georf/StopWatchDisplay/7segment/7segment.kicad_pcb

## KiCad design 7segment/7segment.kicad_pcb (2021-03-15)

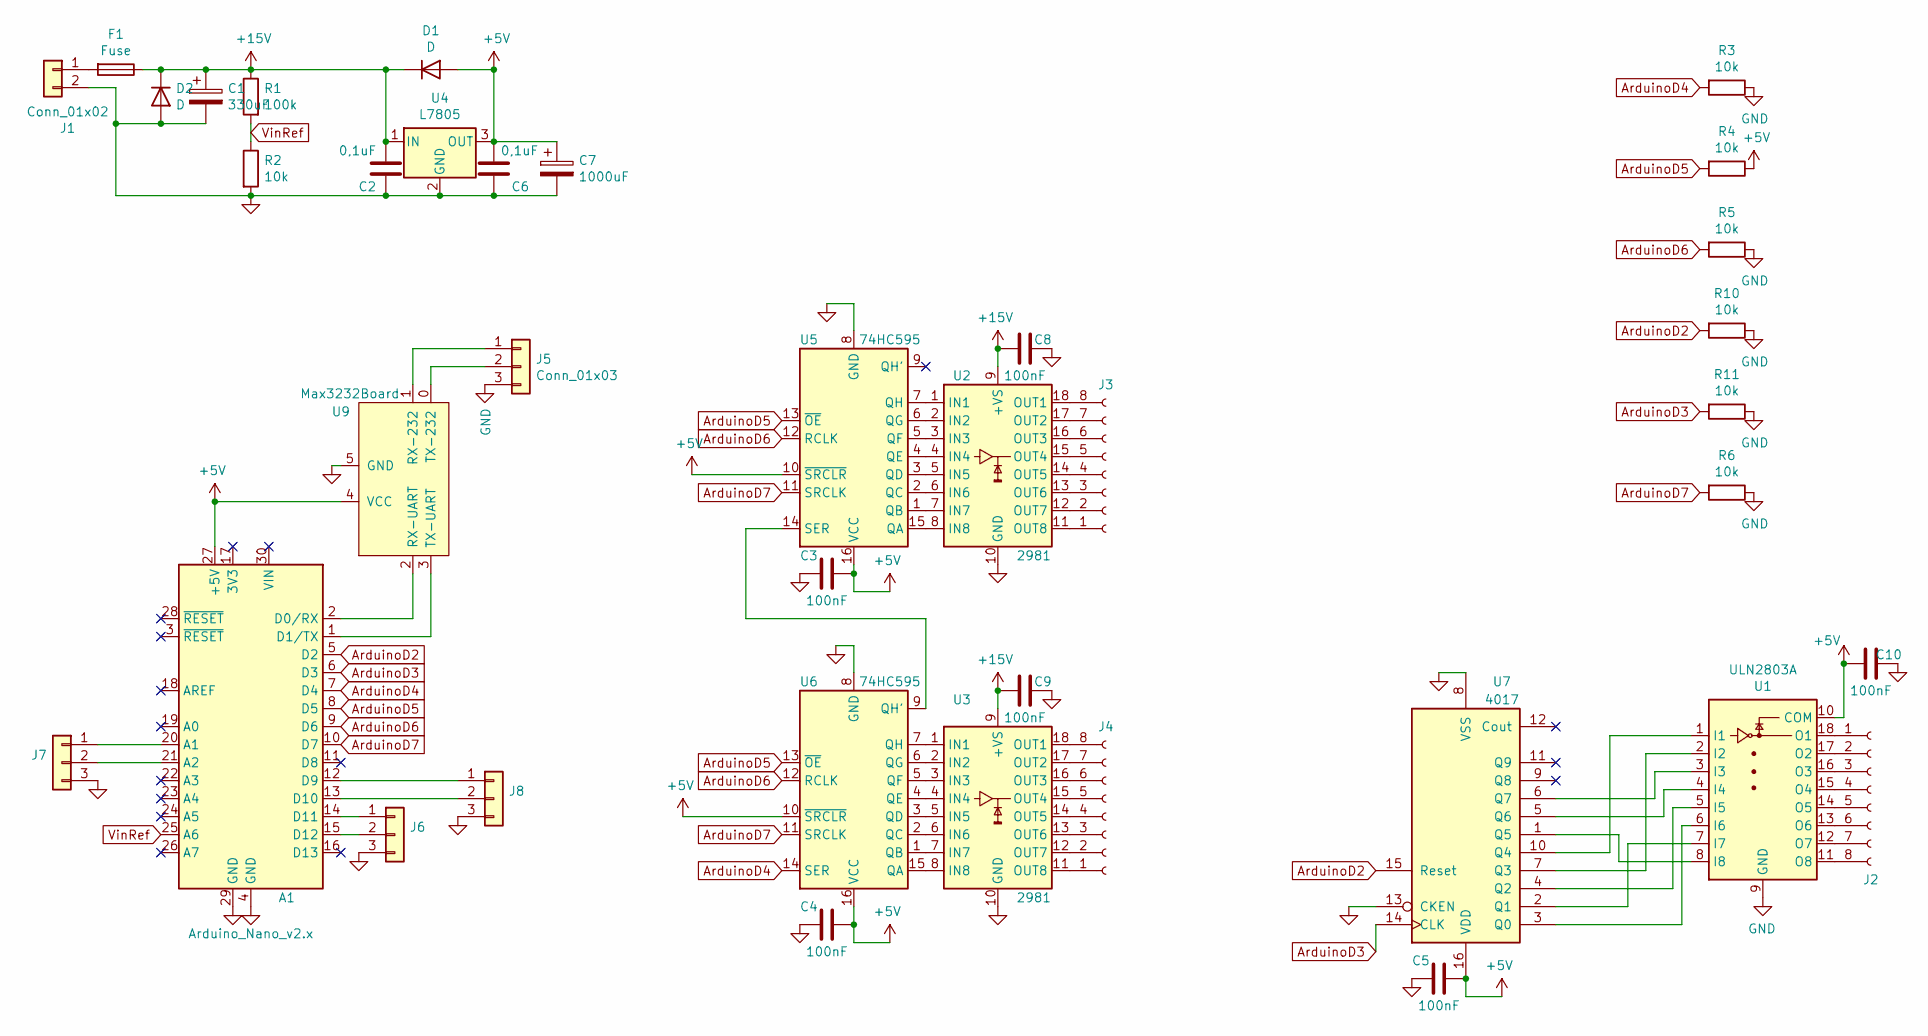
[picture p1: schematic 7segment.sch]

Parts:
A1: Arduino_Nano_v2.x; Arduino_Nano
C1: 330uF; CP_Radial_D10.0mm_P5.00mm
C2, C6: 0,1uF; C_Disc_D3.4mm_W2.1mm_P2.50mm
C3, C4, C5, C8, C9, C10: 100nF; C_Disc_D5.0mm_W2.5mm_P2.50mm
C7: 1000uF; CP_Radial_D10.0mm_P5.00mm
D1: D; D_A-405_P10.16mm_Horizontal
D2: D; D_A-405_P7.62mm_Horizontal
F1: Fuse
J1: Conn_01x02; Connector 2xPin
J2, J3, J4: Conn_Segments; PinSocket_1x08_P2.54mm_Vertical
J5, J6, J7, J8: Conn_01x03; Connector 3xPin
R1: 100k; Resistor, L6mm,4holes
R2, R4, R6, R11: 10k; Resistor, L6mm,5holes
R3, R10: 10k; Resistor, L6mm,4holes
R5: 10k; Resistor, L6mm,6holes
U1: ULN2803A; DIP-18_W7.62mm_LongPads
U2, U3: 2981; DIP-18_W7.62mm_LongPads
U4: L7805; TO255P1040X460X1968-3
U5, U6: 74HC595; DIP-16_W7.62mm_LongPads
U7: 4017; DIP-16_W7.62mm_LongPads
U9: Max3232Board; MAX232

Connections:
+5V: A1.27 (+5V), C3.2, C4.2, C5.2, C6.2, C7.1, C10.1, D1.2 (A), R4.1, U1.10 (COM), U4.3 (OUT), U5.10 (~SRCLR), U5.16 (VCC), U6.10 (~SRCLR), U6.16 (VCC), U7.16 (VDD), U9.4 (VCC)
+15V: C1.1, C2.2, C8.1, C9.1, D1.1 (K), D2.1 (K), F1.1, R1.1, U2.9 (+VS), U3.9 (+VS), U4.1 (IN)
ArduinoD2: A1.5 (D2), R10.2, U7.15 (Reset)
ArduinoD3: A1.6 (D3), R11.2, U7.14 (CLK)
ArduinoD4: A1.7 (D4), R3.2, U6.14 (SER)
ArduinoD5: A1.8 (D5), R4.2, U5.13 (~OE), U6.13 (~OE)
ArduinoD6: A1.9 (D6), R5.2, U5.12 (RCLK), U6.12 (RCLK)
ArduinoD7: A1.10 (D7), R6.2, U5.11 (SRCLK), U6.11 (SRCLK)
GND: A1.4 (GND), A1.29 (GND), C1.2, C2.1, C3.1, C4.1, C5.1, C6.1, C7.2, C8.2, C9.2, C10.2, D2.2 (A), J1.2, J5.3, J6.3, J7.3, J8.3, R2.2, R3.1, R5.1, R6.1, R10.1, R11.1, U1.9 (GND), U2.10 (GND), U3.10 (GND), U4.2 (GND), U5.8 (GND), U6.8 (GND), U7.8 (VSS), U7.13 (CKEN), U9.5 (GND)
unnamed: A1.1 (D1/TX), U9.3 (TX-UART)
unnamed: A1.2 (D0/RX), U9.2 (RX-UART)
unnamed: A1.12 (D9), J8.1
unnamed: A1.13 (D10), J8.2
unnamed: A1.14 (D11), J6.1
unnamed: A1.15 (D12), J6.2
unnamed: A1.20 (A1), J7.1
unnamed: A1.21 (A2), J7.2
unnamed: F1.2, J1.1
unnamed: J2.1, U1.18 (O1)
unnamed: J2.2, U1.17 (O2)
unnamed: J2.3, U1.16 (O3)
unnamed: J2.4, U1.15 (O4)
unnamed: J2.5, U1.14 (O5)
unnamed: J2.6, U1.13 (O6)
unnamed: J2.7, U1.12 (O7)
unnamed: J2.8, U1.11 (O8)
unnamed: J3.1, U2.11 (NC)
unnamed: J3.2, U2.12 (OUT7)
unnamed: J3.3, U2.13 (OUT6)
unnamed: J3.4, U2.14 (OUT5)
unnamed: J3.5, U2.15 (OUT4)
unnamed: J3.6, U2.16 (OUT3)
unnamed: J3.7, U2.17 (OUT2)
unnamed: J3.8, U2.18 (OUT1)
unnamed: J4.1, U3.11 (NC)
unnamed: J4.2, U3.12 (OUT7)
unnamed: J4.3, U3.13 (OUT6)
unnamed: J4.4, U3.14 (OUT5)
unnamed: J4.5, U3.15 (OUT4)
unnamed: J4.6, U3.16 (OUT3)
unnamed: J4.7, U3.17 (OUT2)
unnamed: J4.8, U3.18 (OUT1)
unnamed: J5.1, U9.1 (RX-232)
unnamed: J5.2, U9.0 (TX-232)
unnamed: U1.1 (I1), U7.10 (Q4)
unnamed: U1.2 (I2), U7.7 (Q3)
unnamed: U1.3 (I3), U7.6 (Q7)
unnamed: U1.4 (I4), U7.5 (Q6)
unnamed: U1.5 (I5), U7.4 (Q2)
unnamed: U1.6 (I6), U7.3 (Q0)
unnamed: U1.7 (I7), U7.2 (Q1)
unnamed: U1.8 (I8), U7.1 (Q5)
unnamed: U2.1 (IN1), U5.7 (QH)
unnamed: U2.2 (IN2), U5.6 (QG)
unnamed: U2.3 (IN3), U5.5 (QF)
unnamed: U2.4 (IN4), U5.4 (QE)
unnamed: U2.5 (IN5), U5.3 (QD)
unnamed: U2.6 (IN6), U5.2 (QC)
unnamed: U2.7 (IN7), U5.1 (QB)
unnamed: U2.8 (IN8), U5.15 (QA)
unnamed: U3.1 (IN1), U6.7 (QH)
unnamed: U3.2 (IN2), U6.6 (QG)
unnamed: U3.3 (IN3), U6.5 (QF)
unnamed: U3.4 (IN4), U6.4 (QE)
unnamed: U3.5 (IN5), U6.3 (QD)
unnamed: U3.6 (IN6), U6.2 (QC)
unnamed: U3.7 (IN7), U6.1 (QB)
unnamed: U3.8 (IN8), U6.15 (QA)
unnamed: U5.14 (SER), U6.9 (QH')
VinRef: A1.25 (A6), R1.2, R2.1

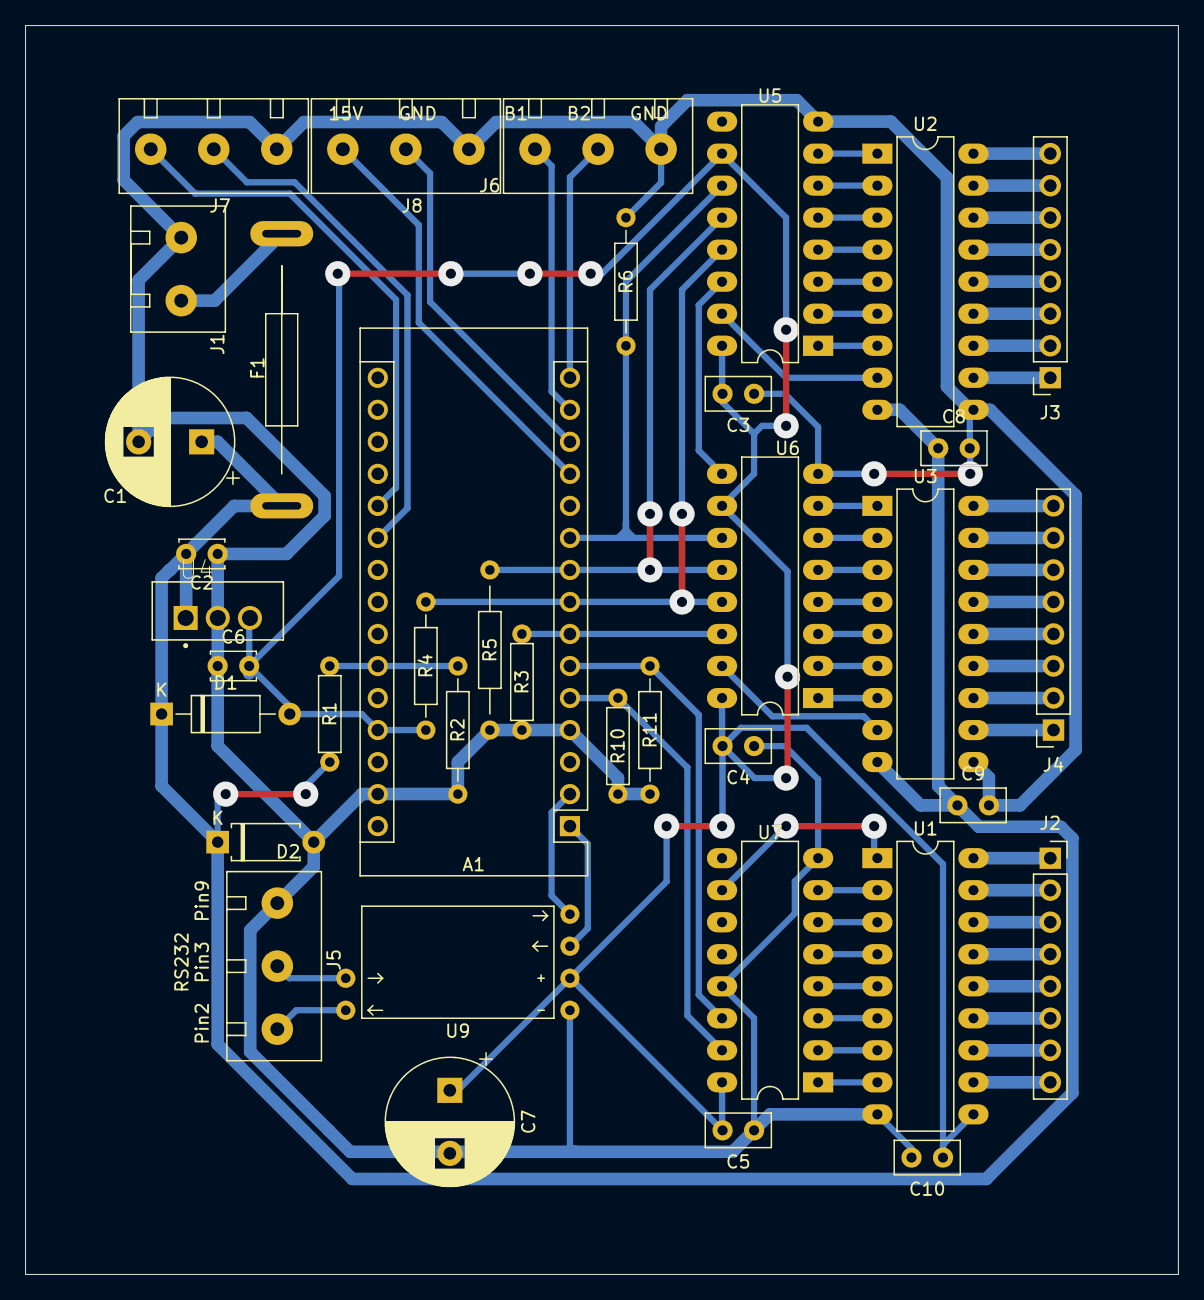
[picture p2: board 7segment.kicad_pcb from above]

Board: 2 copper layers, 91.4 x 99.1 mm, 38 parts (0 on the bottom side), 70 nets.
