georf/StopWatchDisplay/7segment_part/7segment_part.kicad_pcb

## KiCad design 7segment_part/7segment_part.kicad_pcb (2020-10-23)

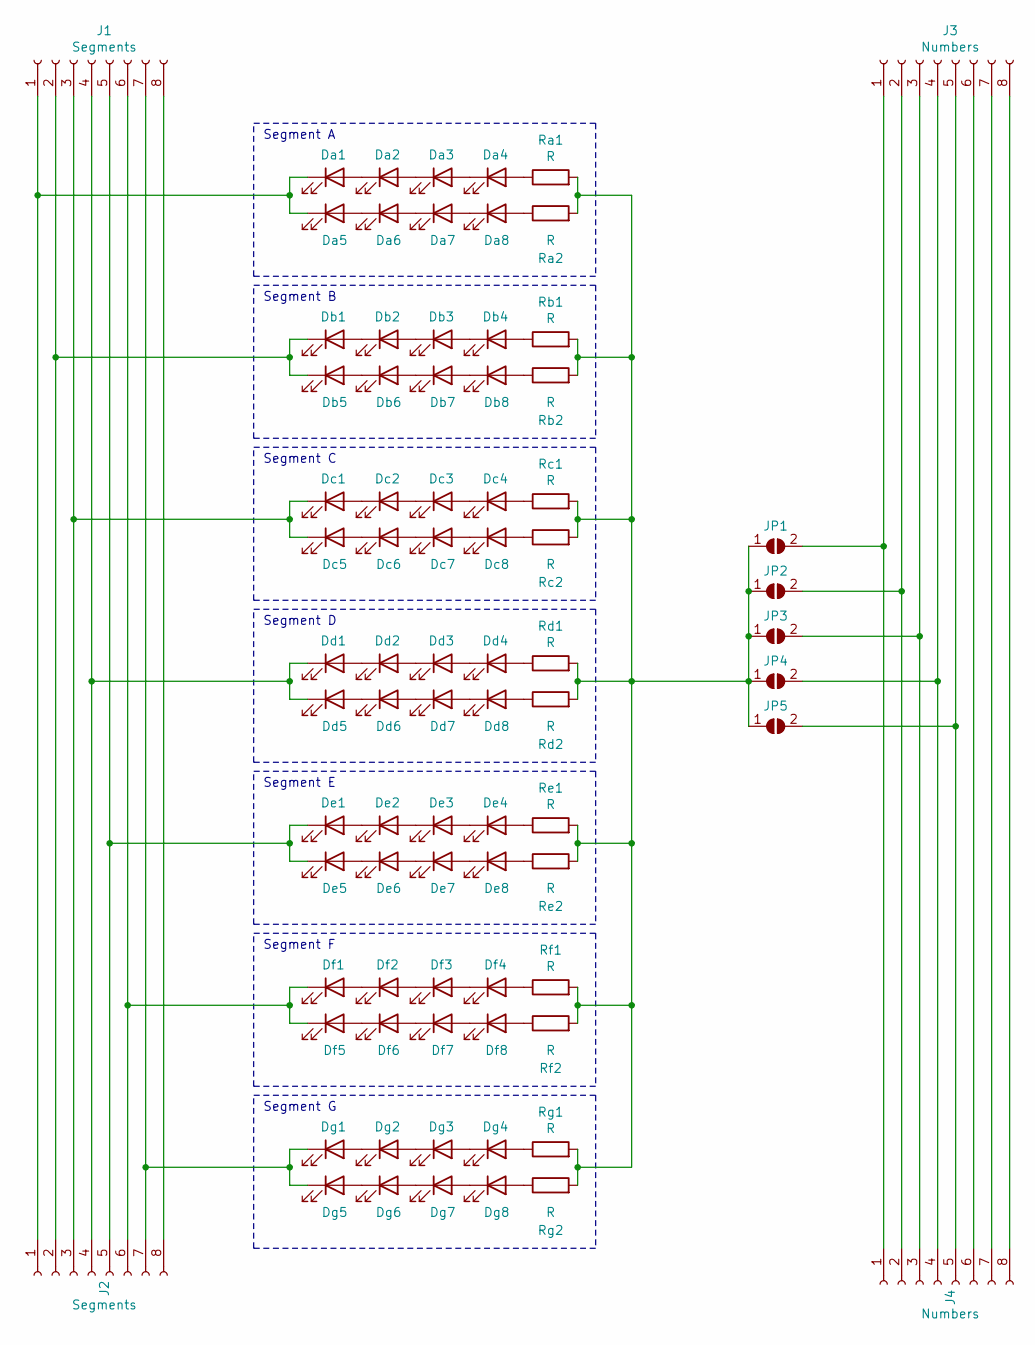
[picture p3: schematic 7segment_part.sch]

Parts:
Da1, Da2, Da3, Da4, Da5, Da6, Da7, Da8: LED; LED_D5.0mm_Clear
Db1, Db2, Db3, Db4, Db5, Db6, Db7, Db8: LED; LED_D5.0mm_Clear
Dc1, Dc2, Dc3, Dc4, Dc5, Dc6, Dc7, Dc8: LED; LED_D5.0mm_Clear
Dd1, Dd2, Dd3, Dd4, Dd5, Dd6, Dd7, Dd8: LED; LED_D5.0mm_Clear
De1, De2, De3, De4, De5, De6, De7, De8: LED; LED_D5.0mm_Clear
Df1, Df2, Df3, Df4, Df5, Df6, Df7, Df8: LED; LED_D5.0mm_Clear
Dg1, Dg2, Dg3, Dg4, Dg5, Dg6, Dg7, Dg8: LED; LED_D5.0mm_Clear
J1, J2: Segments; PinHeader_1x08_P2.54mm_Vertical
J3, J4: Numbers; PinHeader_1x08_P2.54mm_Vertical
JP1, JP2, JP3, JP4, JP5: SolderJumper_2_Open; SolderJumper-2_P1.3mm_Open_Pad1.0x1.5mm
Ra1, Ra2: R; R_1206_3216Metric_Pad1.30x1.75mm_HandSolder
Rb1, Rb2: R; R_1206_3216Metric_Pad1.30x1.75mm_HandSolder
Rc1, Rc2: R; R_1206_3216Metric_Pad1.30x1.75mm_HandSolder
Rd1, Rd2: R; R_1206_3216Metric_Pad1.30x1.75mm_HandSolder
Re1, Re2: R; R_1206_3216Metric_Pad1.30x1.75mm_HandSolder
Rf1, Rf2: R; R_1206_3216Metric_Pad1.30x1.75mm_HandSolder
Rg1, Rg2: R; R_1206_3216Metric_Pad1.30x1.75mm_HandSolder

Connections:
unnamed: Da1.1 (K), Da5.1 (K), J1.1, J2.1
unnamed: Da1.2 (A), Da2.1 (K)
unnamed: Da2.2 (A), Da3.1 (K)
unnamed: Da3.2 (A), Da4.1 (K)
unnamed: Da4.2 (A), Ra1.1
unnamed: Da5.2 (A), Da6.1 (K)
unnamed: Da6.2 (A), Da7.1 (K)
unnamed: Da7.2 (A), Da8.1 (K)
unnamed: Da8.2 (A), Ra2.1
unnamed: Db1.1 (K), Db5.1 (K), J1.2, J2.2
unnamed: Db1.2 (A), Db2.1 (K)
unnamed: Db2.2 (A), Db3.1 (K)
unnamed: Db3.2 (A), Db4.1 (K)
unnamed: Db4.2 (A), Rb1.1
unnamed: Db5.2 (A), Db6.1 (K)
unnamed: Db6.2 (A), Db7.1 (K)
unnamed: Db7.2 (A), Db8.1 (K)
unnamed: Db8.2 (A), Rb2.1
unnamed: Dc1.1 (K), Dc5.1 (K), J1.3, J2.3
unnamed: Dc1.2 (A), Dc2.1 (K)
unnamed: Dc2.2 (A), Dc3.1 (K)
unnamed: Dc3.2 (A), Dc4.1 (K)
unnamed: Dc4.2 (A), Rc1.1
unnamed: Dc5.2 (A), Dc6.1 (K)
unnamed: Dc6.2 (A), Dc7.1 (K)
unnamed: Dc7.2 (A), Dc8.1 (K)
unnamed: Dc8.2 (A), Rc2.1
unnamed: Dd1.1 (K), Dd5.1 (K), J1.4, J2.4
unnamed: Dd1.2 (A), Dd2.1 (K)
unnamed: Dd2.2 (A), Dd3.1 (K)
unnamed: Dd3.2 (A), Dd4.1 (K)
unnamed: Dd4.2 (A), Rd1.1
unnamed: Dd5.2 (A), Dd6.1 (K)
unnamed: Dd6.2 (A), Dd7.1 (K)
unnamed: Dd7.2 (A), Dd8.1 (K)
unnamed: Dd8.2 (A), Rd2.1
unnamed: De1.1 (K), De5.1 (K), J1.5, J2.5
unnamed: De1.2 (A), De2.1 (K)
unnamed: De2.2 (A), De3.1 (K)
unnamed: De3.2 (A), De4.1 (K)
unnamed: De4.2 (A), Re1.1
unnamed: De5.2 (A), De6.1 (K)
unnamed: De6.2 (A), De7.1 (K)
unnamed: De7.2 (A), De8.1 (K)
unnamed: De8.2 (A), Re2.1
unnamed: Df1.1 (K), Df5.1 (K), J1.6, J2.6
unnamed: Df1.2 (A), Df2.1 (K)
unnamed: Df2.2 (A), Df3.1 (K)
unnamed: Df3.2 (A), Df4.1 (K)
unnamed: Df4.2 (A), Rf1.1
unnamed: Df5.2 (A), Df6.1 (K)
unnamed: Df6.2 (A), Df7.1 (K)
unnamed: Df7.2 (A), Df8.1 (K)
unnamed: Df8.2 (A), Rf2.1
unnamed: Dg1.1 (K), Dg5.1 (K), J1.7, J2.7
unnamed: Dg1.2 (A), Dg2.1 (K)
unnamed: Dg2.2 (A), Dg3.1 (K)
unnamed: Dg3.2 (A), Dg4.1 (K)
unnamed: Dg4.2 (A), Rg1.1
unnamed: Dg5.2 (A), Dg6.1 (K)
unnamed: Dg6.2 (A), Dg7.1 (K)
unnamed: Dg7.2 (A), Dg8.1 (K)
unnamed: Dg8.2 (A), Rg2.1
unnamed: J1.8, J2.8
unnamed: J3.1, J4.1, JP1.2 (B)
unnamed: J3.2, J4.2, JP2.2 (B)
unnamed: J3.3, J4.3, JP3.2 (B)
unnamed: J3.4, J4.4, JP4.2 (B)
unnamed: J3.5, J4.5, JP5.2 (B)
unnamed: J3.6, J4.6
unnamed: J3.7, J4.7
unnamed: J3.8, J4.8
unnamed: JP1.1 (A), JP2.1 (A), JP3.1 (A), JP4.1 (A), JP5.1 (A), Ra1.2, Ra2.2, Rb1.2, Rb2.2, Rc1.2, Rc2.2, Rd1.2, Rd2.2, Re1.2, Re2.2, Rf1.2, Rf2.2, Rg1.2, Rg2.2

Notes on the sheet:
Segment A
Segment B
Segment C
Segment D
Segment E
Segment F
Segment G

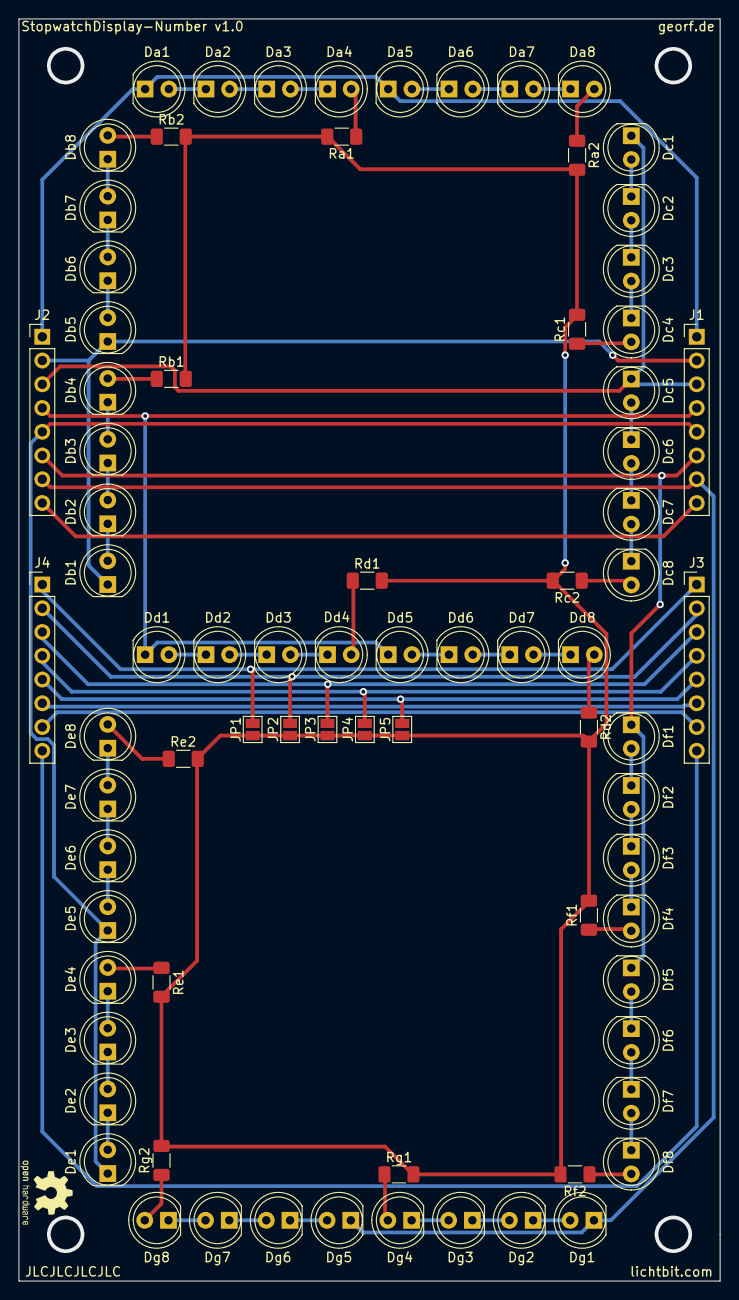
[picture p4: board 7segment_part/7segment_part.kicad_pcb from above]

Board: 2 copper layers, 75.0 x 135.0 mm, 79 parts (0 on the bottom side), 73 nets.
