georf/StopWatchDisplay/7segment_dots/7segment_part.kicad_pcb

## KiCad design 7segment_dots/7segment_part.kicad_pcb (2020-10-23, an earlier design)

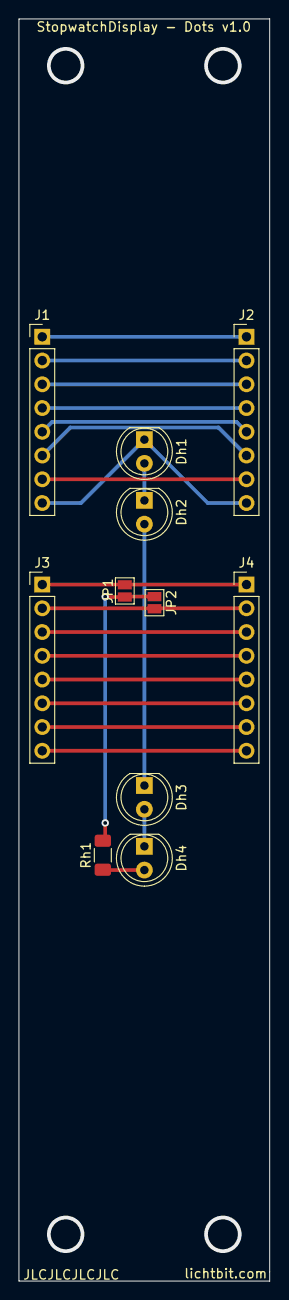
[picture p5: board 7segment_dots/7segment_part.kicad_pcb from above]

Board: 2 copper layers, 26.8 x 135.0 mm, 11 parts (0 on the bottom side), 21 nets.

Parts:
Dh1, Dh2, Dh3, Dh4: LED; LED_D5.0mm_Clear
J1, J2: Segments; PinHeader_1x08_P2.54mm_Vertical
J3, J4: Numbers; PinHeader_1x08_P2.54mm_Vertical
JP1, JP2: SolderJumper_2_Open; SolderJumper-2_P1.3mm_Open_Pad1.0x1.5mm
Rh1: R; R_1206_3216Metric_Pad1.30x1.75mm_HandSolder

Connections:
unnamed: Dh1.1, J1.8, J2.8
unnamed: Dh1.2, Dh2.1
unnamed: Dh2.2, Dh3.1
unnamed: Dh3.2, Dh4.1
unnamed: Dh4.2, Rh1.1
unnamed: J1.1, J2.1
unnamed: J1.2, J2.2
unnamed: J1.3, J2.3
unnamed: J1.4, J2.4
unnamed: J1.5, J2.5
unnamed: J1.6, J2.6
unnamed: J1.7, J2.7
unnamed: J3.1, J4.1, JP1.2
unnamed: J3.2, J4.2, JP2.2
unnamed: J3.3, J4.3
unnamed: J3.4, J4.4
unnamed: J3.5, J4.5
unnamed: J3.6, J4.6
unnamed: J3.7, J4.7
unnamed: J3.8, J4.8
unnamed: JP1.1, JP2.1, Rh1.2
