georf/StopWatchDisplay/(commit log)

2020-10-23 KiCad-Projekt: Teilanzeige Punkte
    [7segment_part-B_Cu.gbr, 7segment_part-B_Mask.gbr, 7segment_part-B_Paste.gbr, 7segment_part-B_SilkS.gbr, 7segment_part-Edge_Cuts.gbr, 7segment_part-F_Cu.gbr, 7segment_part-F_Mask.gbr, 7segment_part-F_Paste.gbr]
2020-10-23 KiCad-Projekt: Teilanzeige Nummer
    [7segment_part-B_Cu.gbr, 7segment_part-B_Mask.gbr, 7segment_part-B_Paste.gbr, 7segment_part-B_SilkS.gbr, 7segment_part-Edge_Cuts.gbr, 7segment_part-F_Cu.gbr, 7segment_part-F_Mask.gbr, 7segment_part-F_Paste.gbr]
2020-10-23 KiCad-Projekt: Hauptplatine
    [7segment-B_Cu.gbr, 7segment-B_Mask.gbr, 7segment-B_Paste.gbr, 7segment-B_SilkS.gbr, 7segment-Edge_Cuts.gbr, 7segment-F_Cu.gbr, 7segment-F_Mask.gbr, 7segment-F_Paste.gbr]
2020-10-23 C-Projekt für Arduino
2021-03-15 KiCad: Platinen Version 1
    [7segment.kicad_pcb, 7segment.sch]
2021-03-15 Stoppuhr-Computer mit Arduino simulieren
2021-10-09 Konvertierung der Zeiten korrigieren
    [serial_control.cc]
